naterjlevy-a11y/sonar-guard/media/dash-alert.jpg

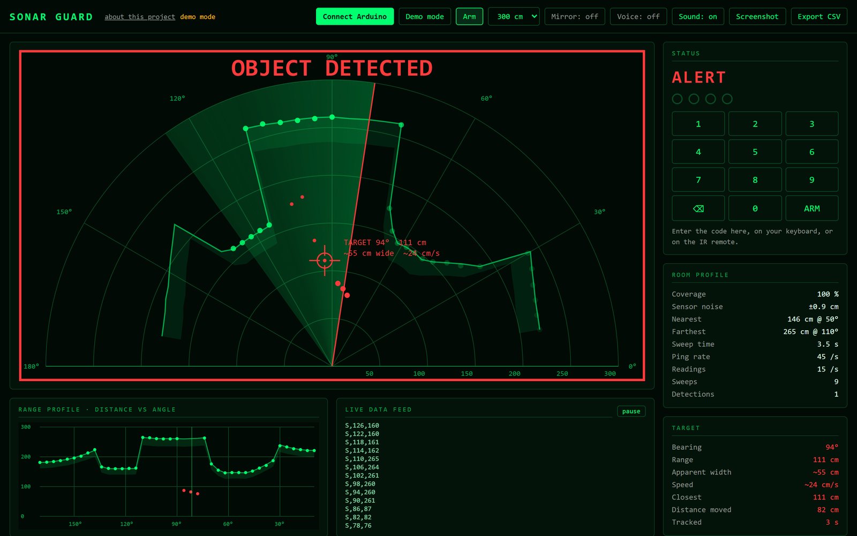
media/dash-alert.jpg
