naterjlevy-a11y/sonar-guard/media/dash-report.jpg

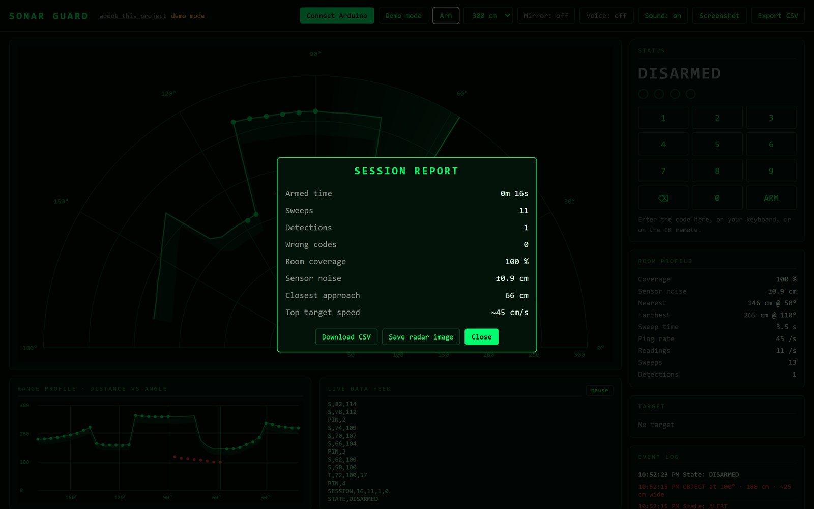
media/dash-report.jpg
